TimTini/stackable-bin-rack/mockups/modular-pitch/preview.png

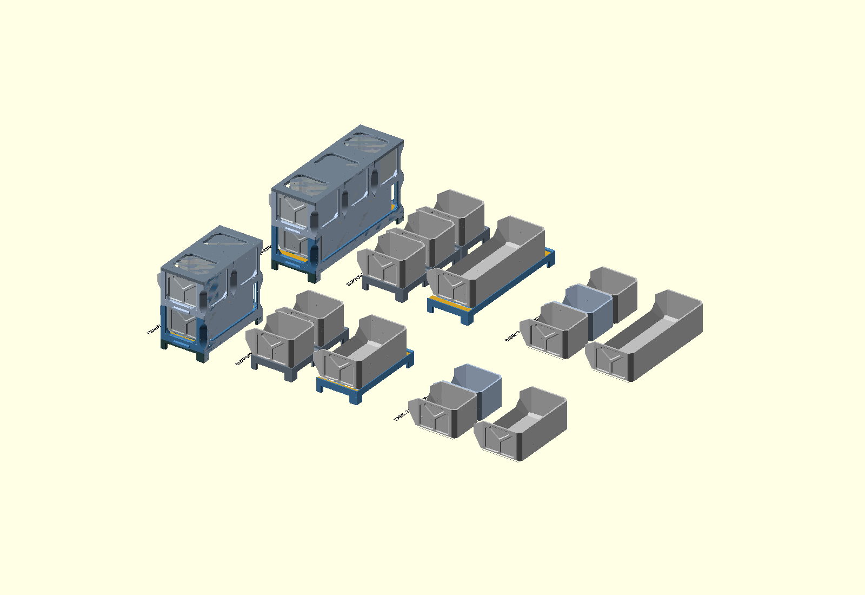
mockups/modular-pitch/preview.png
