TimTini/stackable-bin-rack/mockups/modular-pitch/shared-divider-detail.png

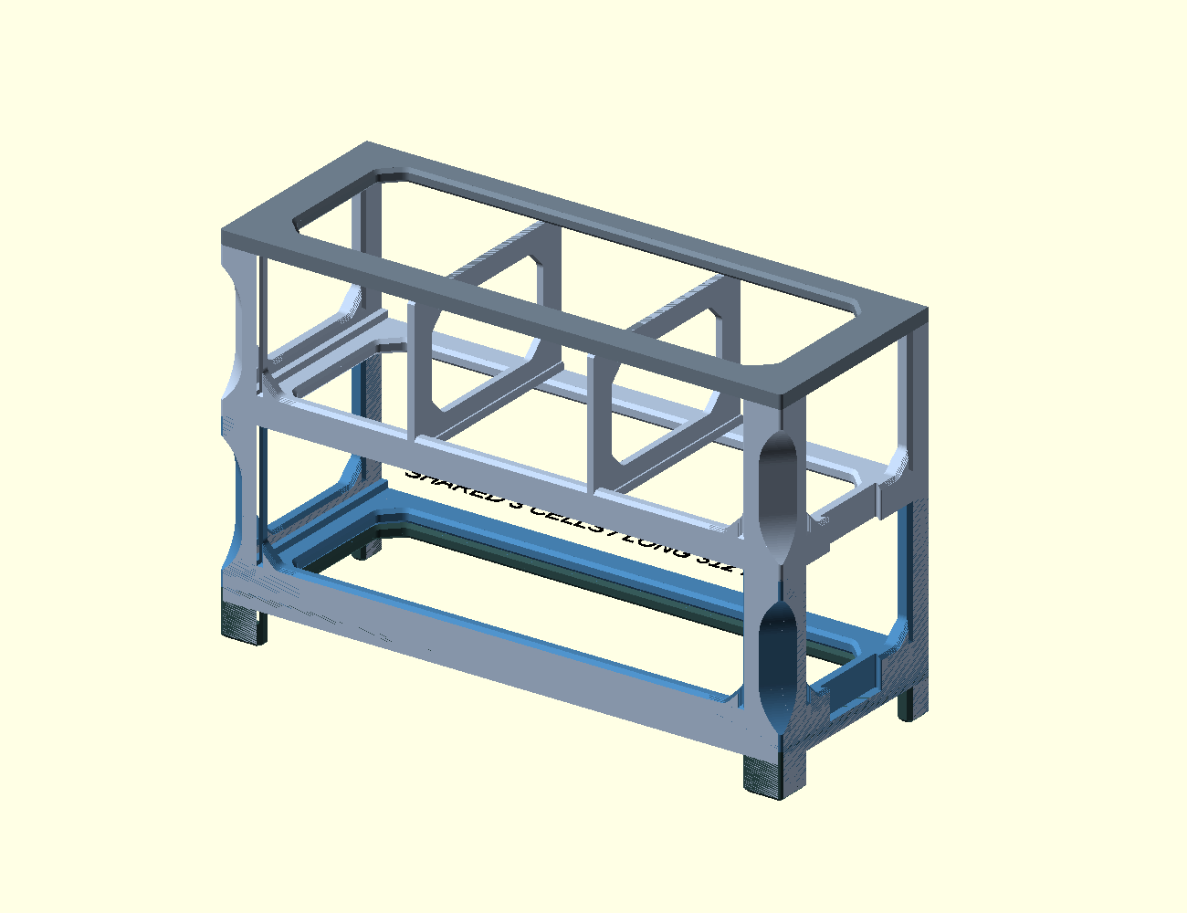
mockups/modular-pitch/shared-divider-detail.png
