TimTini/stackable-bin-rack/mockups/modular-pitch/shared-preview.png

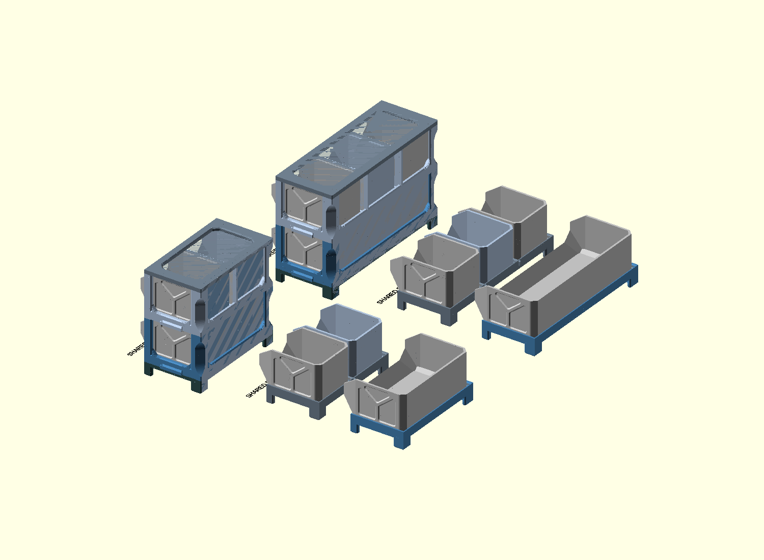
mockups/modular-pitch/shared-preview.png
