TimTini/stackable-bin-rack/exports/size-multiplier/1x1x1/stand_bin.stl

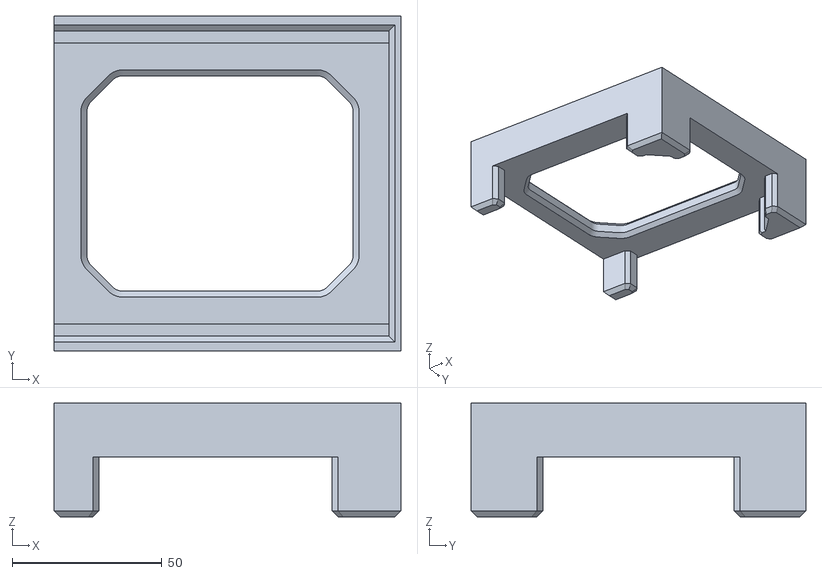
[picture p10: CAD file, 2026-10-26]
exports/size-multiplier/1x1x1/stand_bin.stl
116.0 x 112.0 x 38.0
