TimTini/stackable-bin-rack/exports/size-multiplier/1x3x2/stand_bin.stl

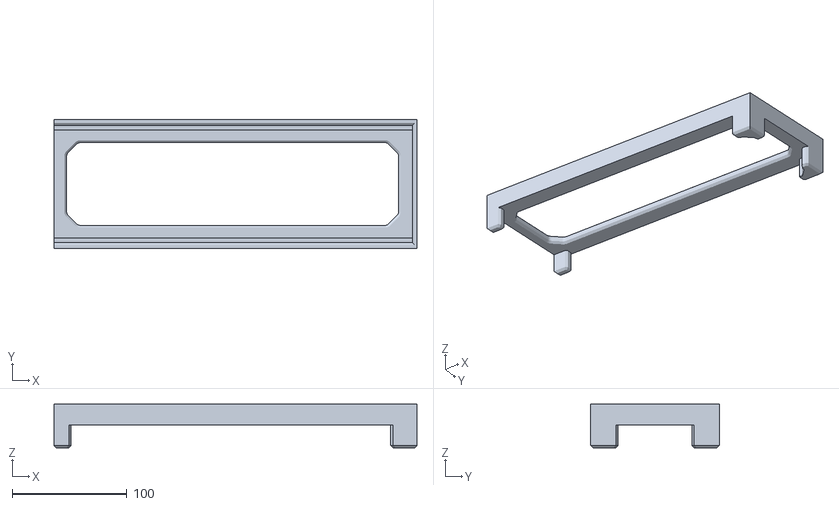
[picture p12: CAD file, 2026-10-26]
exports/size-multiplier/1x3x2/stand_bin.stl
316.0 x 112.0 x 38.0
