TimTini/stackable-bin-rack/exports/size-multiplier/2x1x1/stand_bin.stl

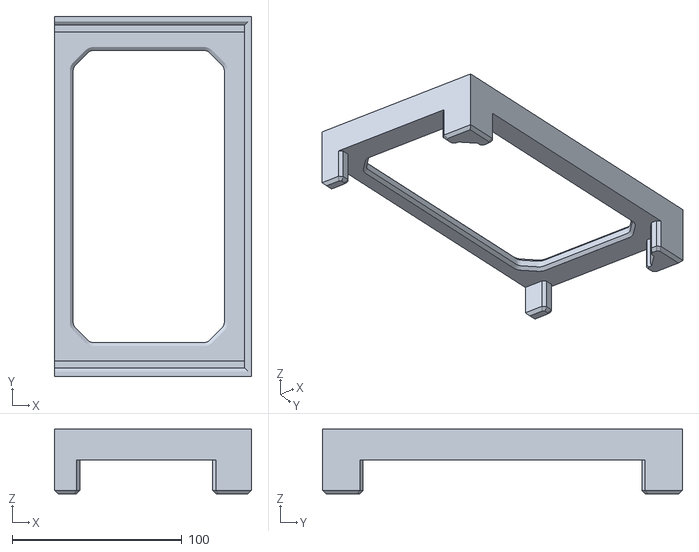
[picture p13: CAD file, 2026-10-26]
exports/size-multiplier/2x1x1/stand_bin.stl
116.0 x 212.0 x 38.0
