TimTini/stackable-bin-rack/exports/size-multiplier/2x2x2/stand.stl

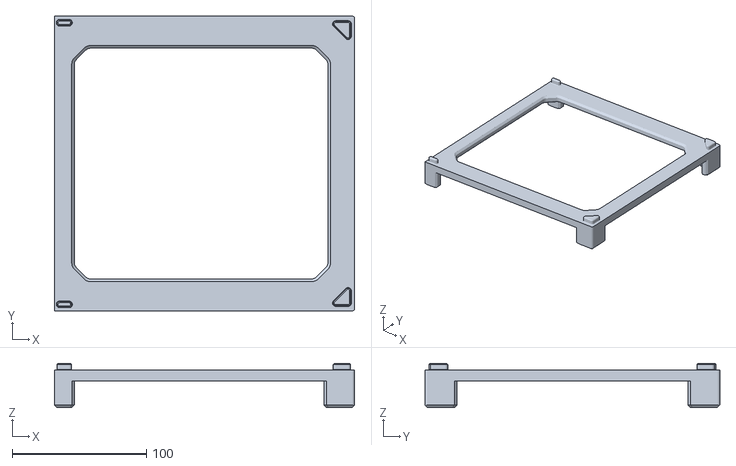
[picture p14: CAD file, 2026-10-26]
exports/size-multiplier/2x2x2/stand.stl
224.0 x 219.9 x 33.0
