TimTini/stackable-bin-rack/exports/size-multiplier/3x1x1/stand_bin.stl

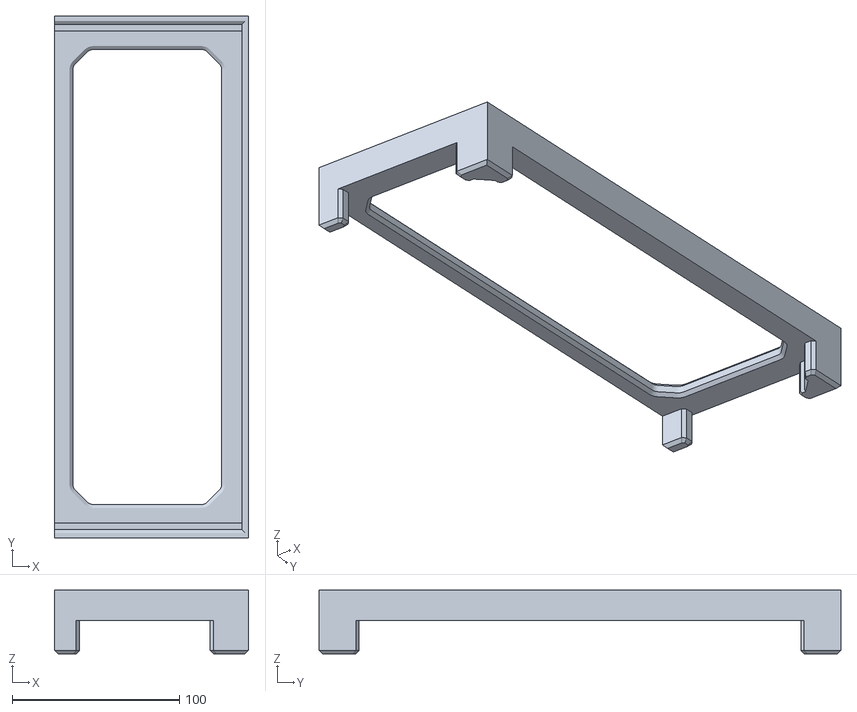
[picture p15: CAD file, 2026-10-26]
exports/size-multiplier/3x1x1/stand_bin.stl
116.0 x 312.0 x 38.0
