TimTini/stackable-bin-rack/exports/size-multiplier/1x1x1/stand.stl

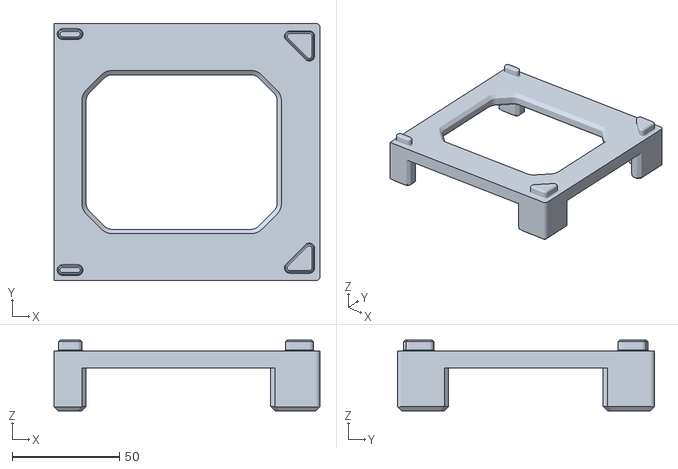
[picture p16: CAD file, 2026-10-26]
exports/size-multiplier/1x1x1/stand.stl
124.0 x 119.9 x 33.0
