TimTini/stackable-bin-rack/exports/size-multiplier/1x2x1/stand_bin.stl

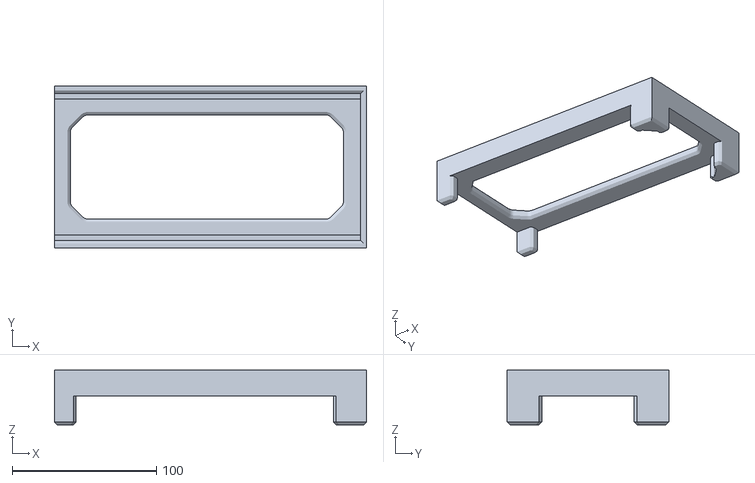
[picture p17: CAD file, 2026-10-26]
exports/size-multiplier/1x2x1/stand_bin.stl
216.0 x 112.0 x 38.0
