TimTini/stackable-bin-rack/exports/size-multiplier/1x3x2/stand.stl

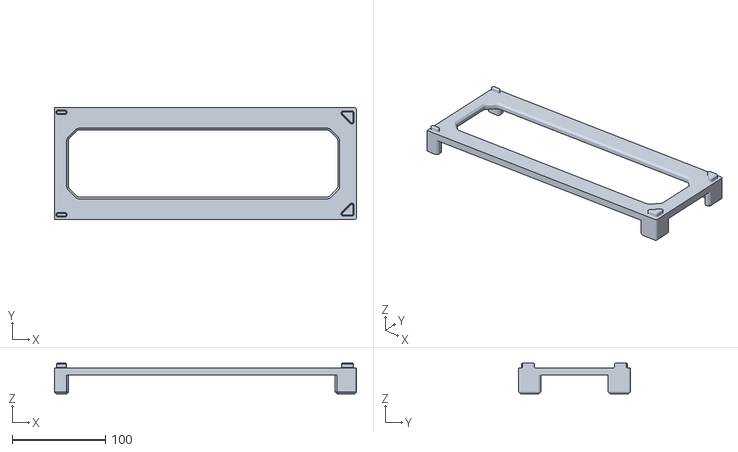
[picture p18: CAD file, 2026-10-26]
exports/size-multiplier/1x3x2/stand.stl
324.0 x 119.9 x 33.0
