TimTini/stackable-bin-rack/exports/size-multiplier/2x2x2/stand_bin.stl

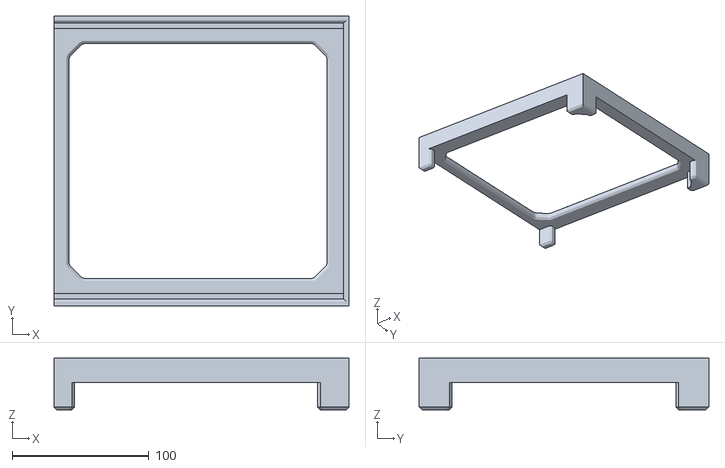
[picture p20: CAD file, 2026-10-26]
exports/size-multiplier/2x2x2/stand_bin.stl
216.0 x 212.0 x 38.0
