TimTini/stackable-bin-rack/exports/size-multiplier/3x1x1/stand.stl

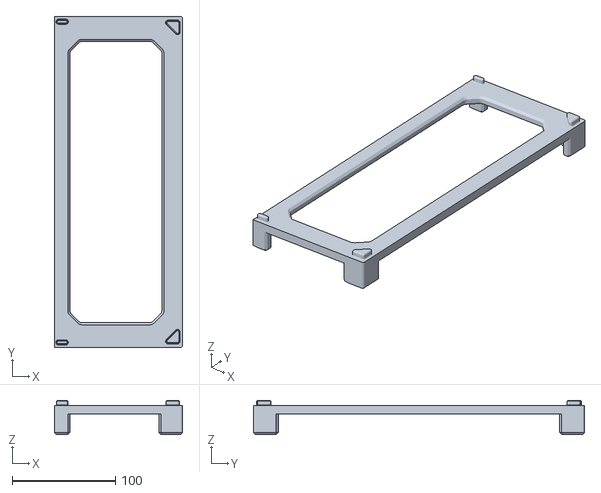
[picture p21: CAD file, 2026-10-26]
exports/size-multiplier/3x1x1/stand.stl
124.0 x 319.9 x 33.0
