TimTini/stackable-bin-rack/exports/size-multiplier/1x1x1/cap.stl

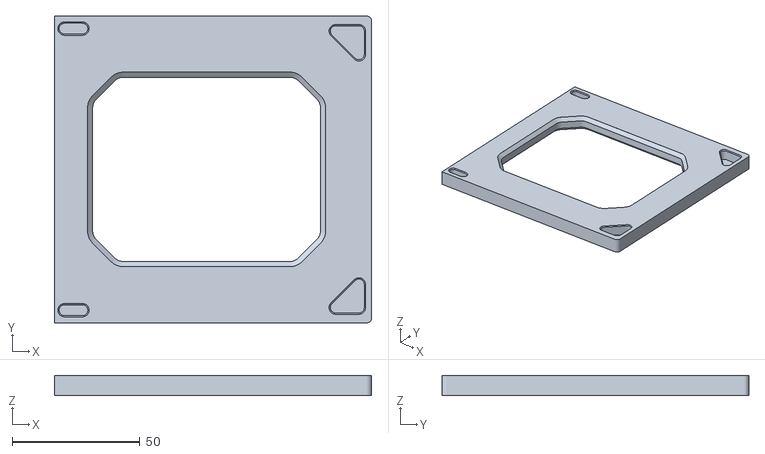
[picture p22: CAD file, 2026-10-26]
exports/size-multiplier/1x1x1/cap.stl
124.0 x 119.9 x 8.00
