TimTini/stackable-bin-rack/exports/size-multiplier/1x1x2/bin.stl

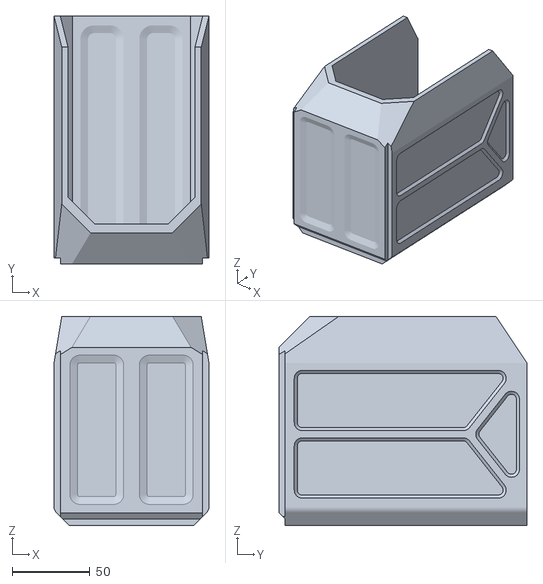
[picture p23: CAD file, 2026-10-26]
exports/size-multiplier/1x1x2/bin.stl
100.0 x 160.0 x 135.0
