TimTini/stackable-bin-rack/exports/size-multiplier/1x3x2/frame.stl

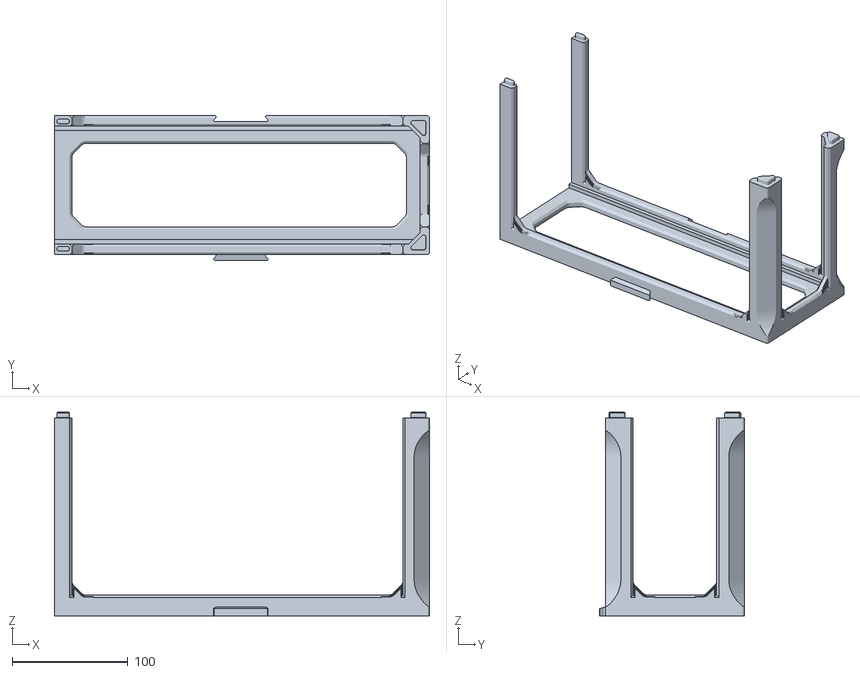
[picture p25: CAD file, 2026-10-26]
exports/size-multiplier/1x3x2/frame.stl
324.0 x 124.9 x 176.0
