TimTini/stackable-bin-rack/exports/size-multiplier/2x1x1/bin.stl

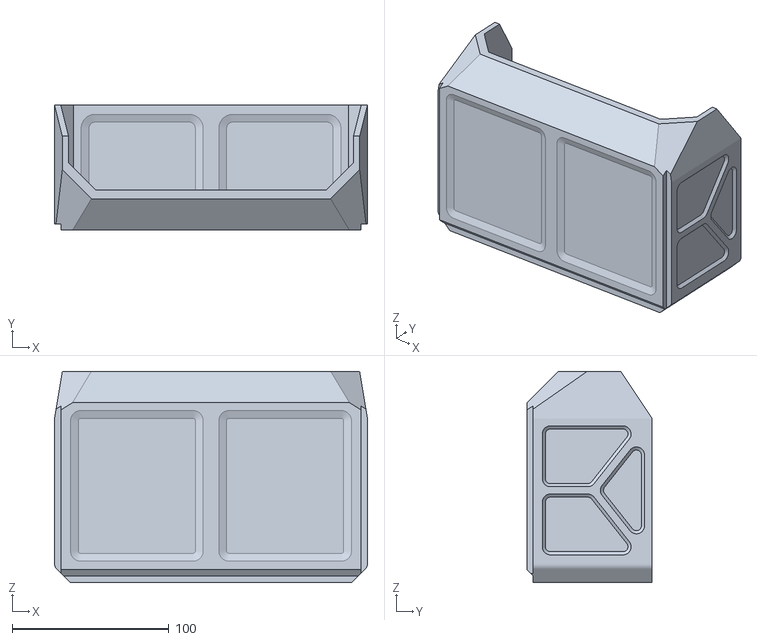
[picture p26: CAD file, 2026-10-26]
exports/size-multiplier/2x1x1/bin.stl
200.0 x 80.0 x 135.0
