TimTini/stackable-bin-rack/exports/size-multiplier/2x2x2/frame.stl

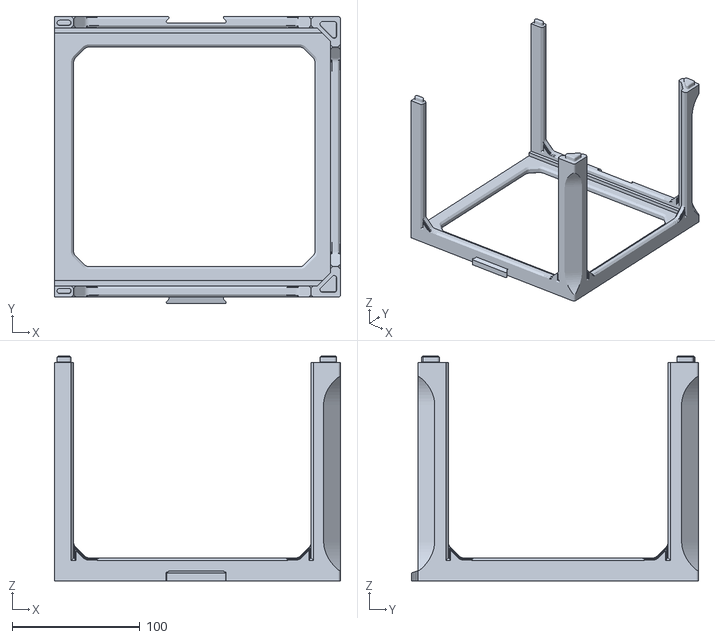
[picture p27: CAD file, 2026-10-26]
exports/size-multiplier/2x2x2/frame.stl
224.0 x 224.9 x 176.0
