TimTini/stackable-bin-rack/exports/size-multiplier/3x1x1/cap.stl

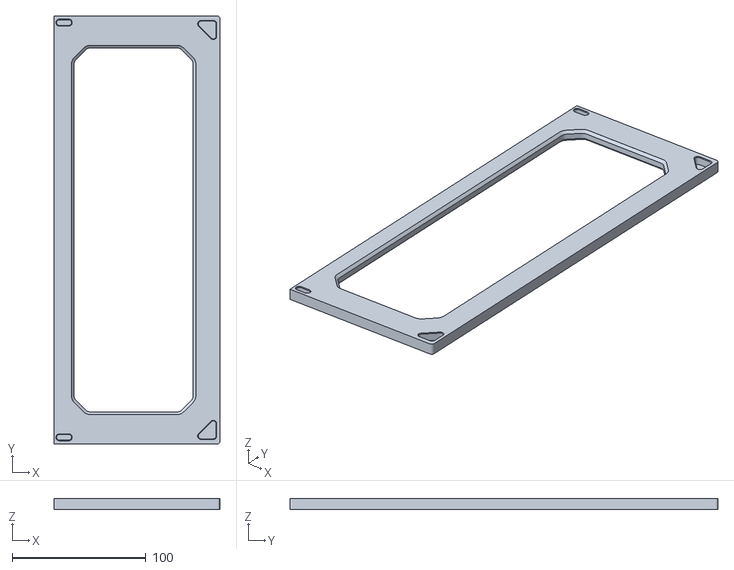
[picture p28: CAD file, 2026-10-26]
exports/size-multiplier/3x1x1/cap.stl
124.0 x 319.9 x 8.00
