TimTini/stackable-bin-rack/exports/size-multiplier/1x1x1/bin.stl

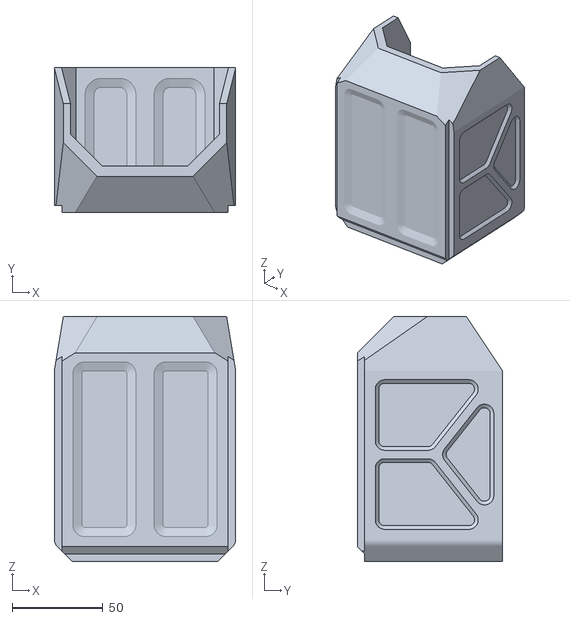
[picture p29: CAD file, 2026-10-26]
exports/size-multiplier/1x1x1/bin.stl
100.0 x 80.0 x 135.0
