TimTini/stackable-bin-rack/exports/size-multiplier/1x2x1/bin.stl

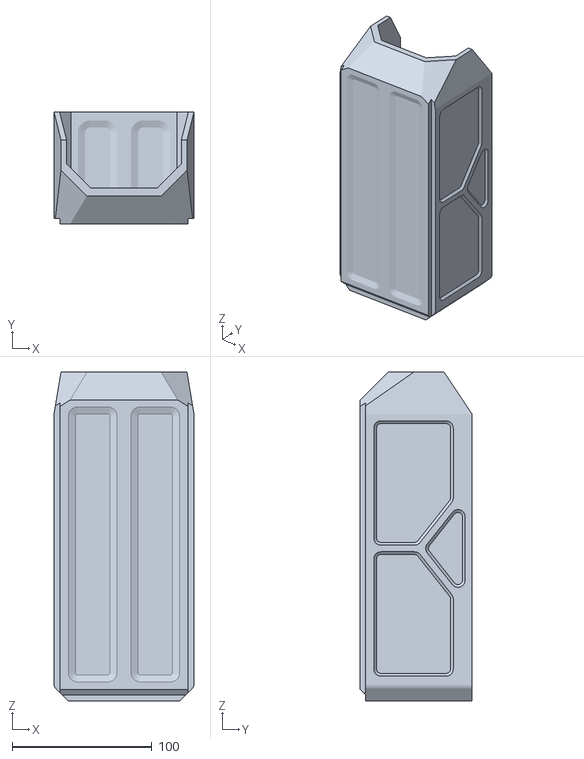
[picture p30: CAD file, 2026-10-26]
exports/size-multiplier/1x2x1/bin.stl
100.0 x 80.0 x 235.0
