TimTini/stackable-bin-rack/exports/size-multiplier/1x3x2/cap.stl

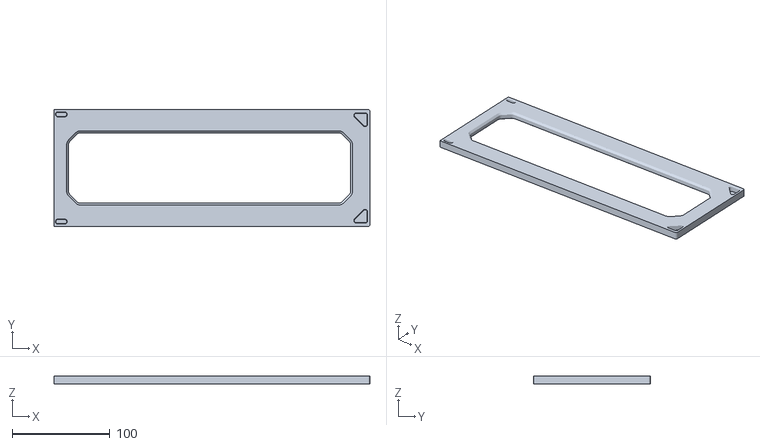
[picture p31: CAD file, 2026-10-26]
exports/size-multiplier/1x3x2/cap.stl
324.0 x 119.9 x 8.00
