TimTini/stackable-bin-rack/exports/size-multiplier/2x2x2/bin.stl

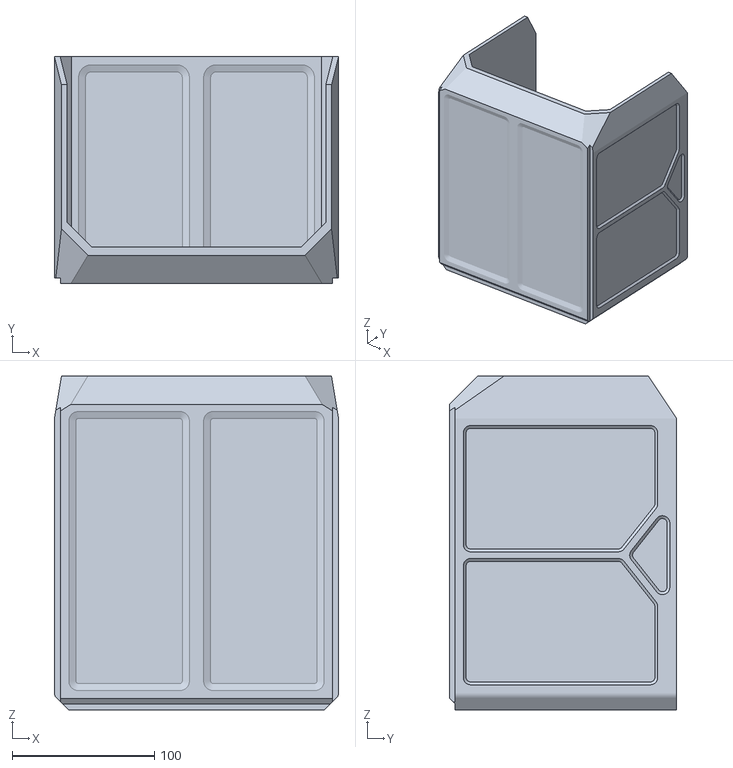
[picture p33: CAD file, 2026-10-26]
exports/size-multiplier/2x2x2/bin.stl
200.0 x 160.0 x 235.0
