TimTini/stackable-bin-rack/exports/size-multiplier/3x1x1/frame.stl

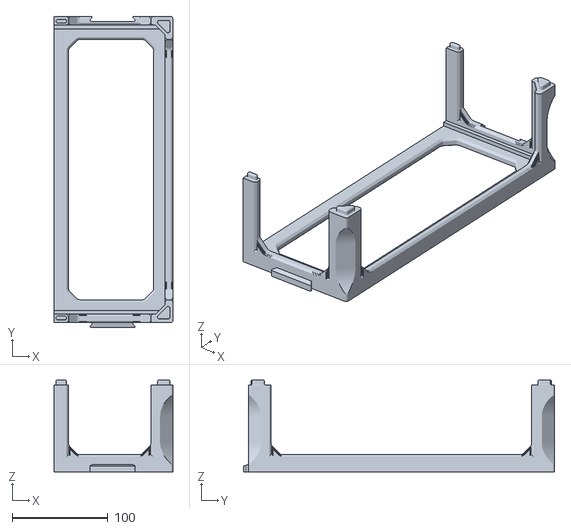
[picture p34: CAD file, 2026-10-26]
exports/size-multiplier/3x1x1/frame.stl
124.0 x 324.9 x 96.0
