TimTini/stackable-bin-rack/exports/size-multiplier/1x1x1/frame.stl

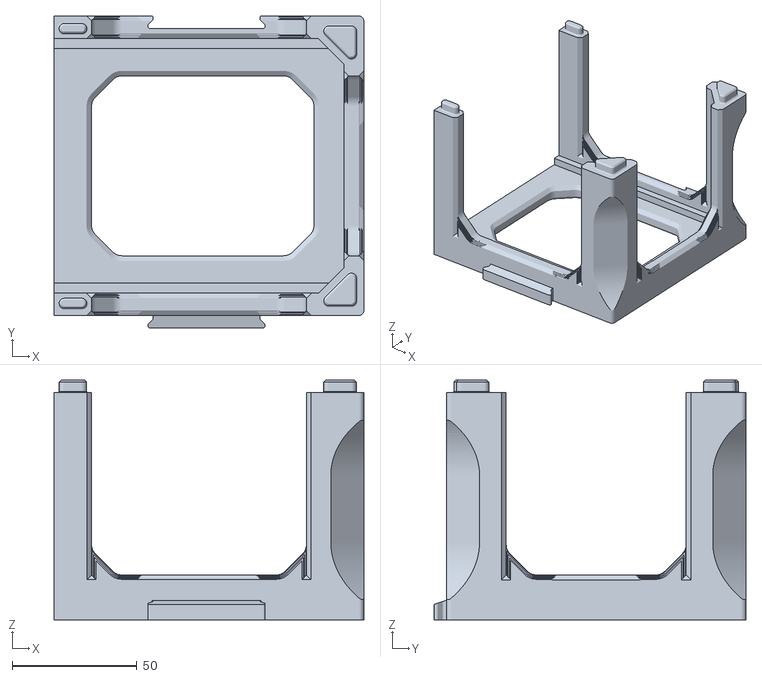
[picture p35: CAD file, 2026-10-26]
exports/size-multiplier/1x1x1/frame.stl
124.0 x 124.9 x 96.0
