TimTini/stackable-bin-rack/exports/size-multiplier/1x1x2/frame.stl

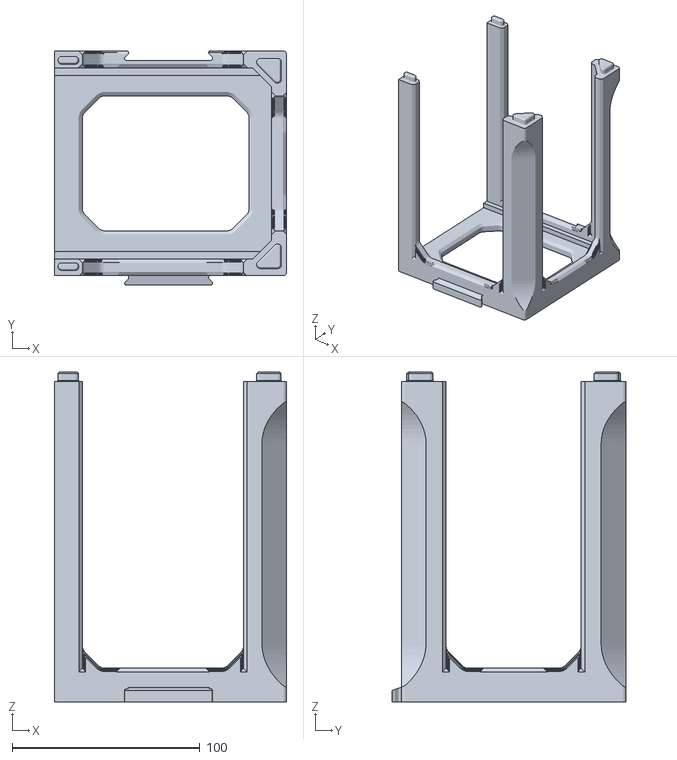
[picture p36: CAD file, 2026-10-26]
exports/size-multiplier/1x1x2/frame.stl
124.0 x 124.9 x 176.0
