TimTini/stackable-bin-rack/exports/size-multiplier/1x2x1/cap.stl

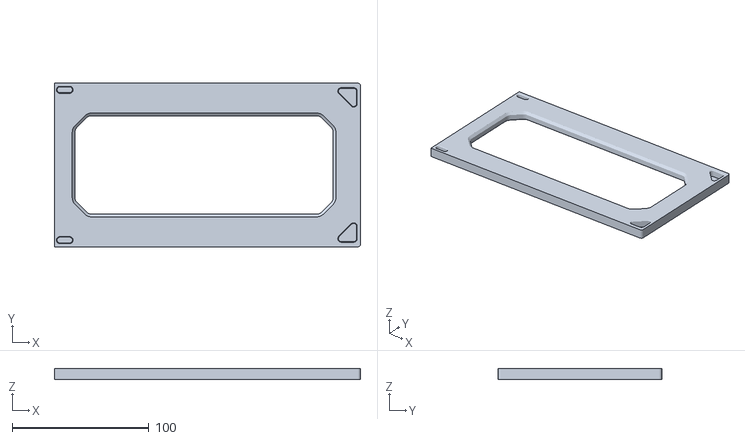
[picture p37: CAD file, 2026-10-26]
exports/size-multiplier/1x2x1/cap.stl
224.0 x 119.9 x 8.00
