TimTini/stackable-bin-rack/exports/size-multiplier/1x3x2/bin.stl

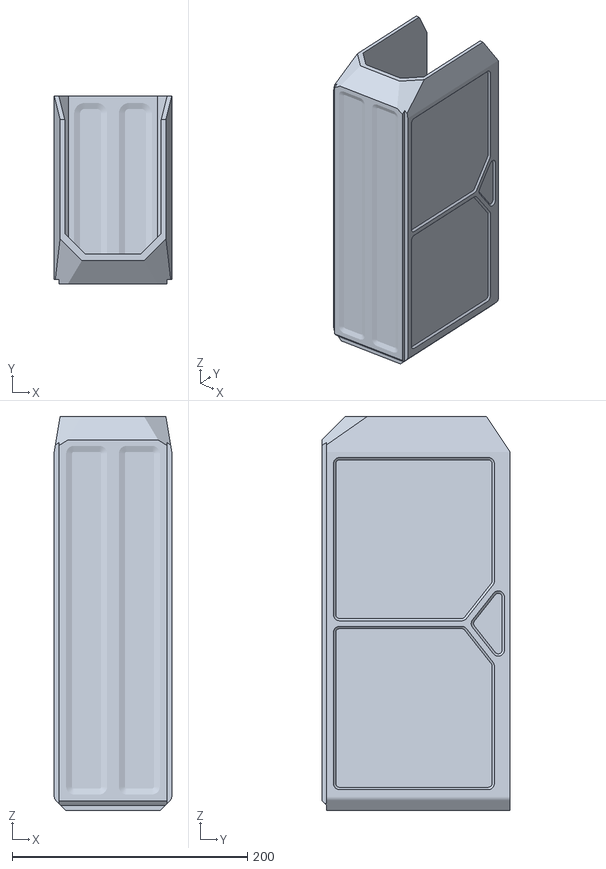
[picture p38: CAD file, 2026-10-26]
exports/size-multiplier/1x3x2/bin.stl
100.0 x 160.0 x 335.0
