TimTini/stackable-bin-rack/exports/size-multiplier/2x1x1/cap.stl

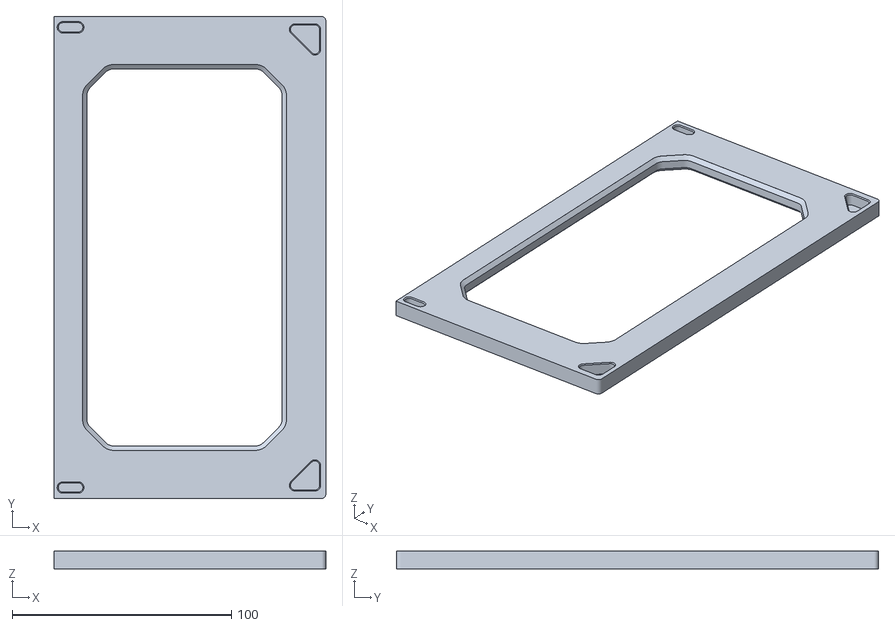
[picture p39: CAD file, 2026-10-26]
exports/size-multiplier/2x1x1/cap.stl
124.0 x 219.9 x 8.00
