TimTini/stackable-bin-rack/exports/size-multiplier/2x2x2/cap.stl

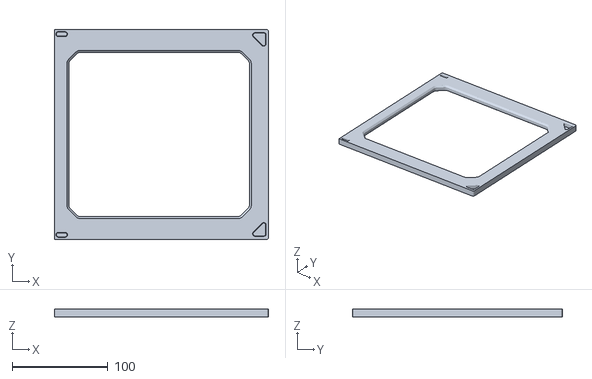
[picture p40: CAD file, 2026-10-26]
exports/size-multiplier/2x2x2/cap.stl
224.0 x 219.9 x 8.00
