TimTini/stackable-bin-rack/exports/size-multiplier/3x1x1/bin.stl

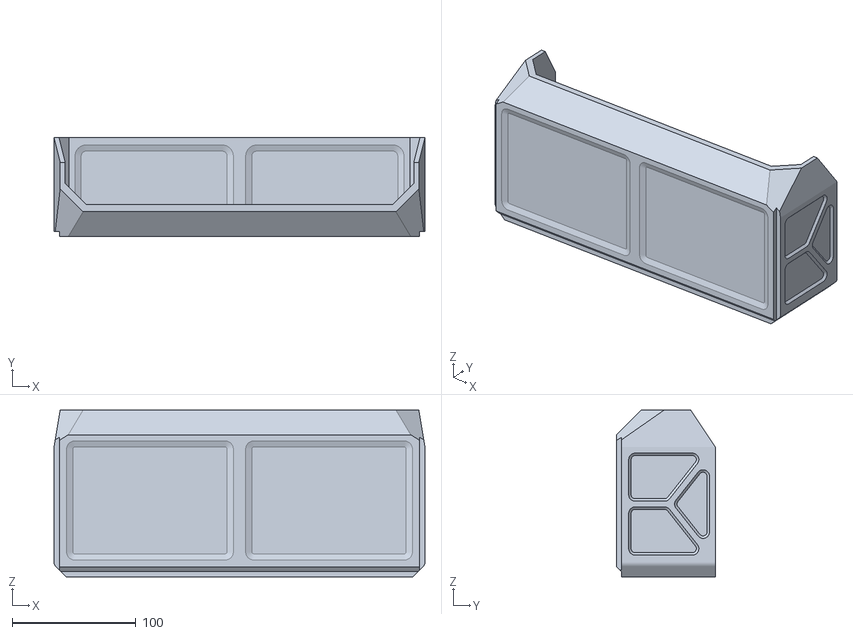
[picture p41: CAD file, 2026-10-26]
exports/size-multiplier/3x1x1/bin.stl
300.0 x 80.0 x 135.0
