TimTini/stackable-bin-rack/(list of files, cad)

Other CAD files:
mockups/modular-pitch/model.scad
