TimTini/stackable-bin-rack/(commit log)

2026-10-26 Publish portable CAD sources and validated artifacts
    [bin.stl, cap.stl, check_assembly.scad, frame.stl, stackable-bin-rack.scad, stand.stl, stand_bin.stl]
2026-10-26 Preserve exact CAD source and artifact bytes across clones
    [check_assembly.scad, stackable-bin-rack.scad]
2026-10-26 Align stand feet with plate corners and equalize braces
    [stackable-bin-rack.scad, stand.stl, stand_bin.stl]
2026-10-26 Remove four front and rear stand braces
    [stackable-bin-rack.scad, stand.stl, stand_bin.stl]
2026-10-26 Remove the remaining triangular braces from both stands.
    [stackable-bin-rack.scad, stand.stl, stand_bin.stl]
2026-10-28 Add isolated modular pitch assembly mockup
    [assembly.scad, model.scad]
2026-10-28 Add shared outer frame divided-cell mockup
    [shared-assembly.scad]
2026-10-28 Match mockup dividers to rack window and rail style
    [shared-assembly.scad]
2026-11-07 Ignore local Fusion mesh dumps and zip archives.
    Keep accidental STL/F3D exports and user zip files out of the public tree.
